Marcimedes/JBC_T245_Controller/Pinouts/jbc_iron_stand_pinout(BINDER_99-0624-00-07).JPG

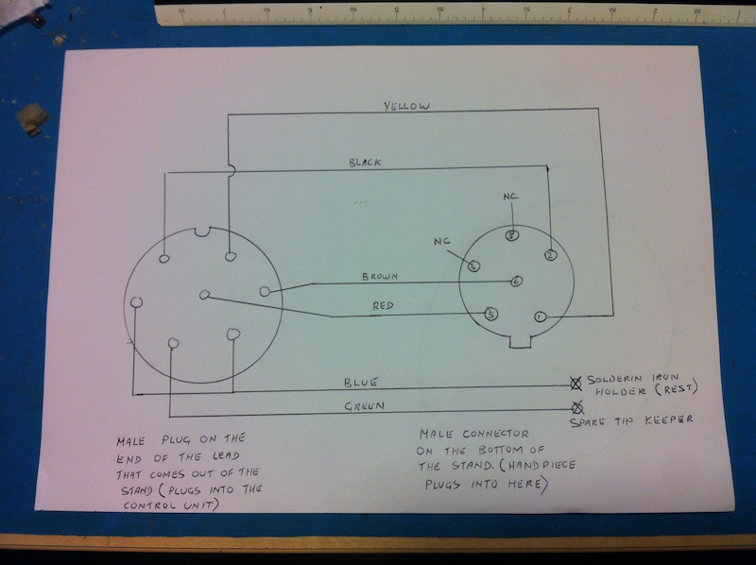
Pinouts/jbc_iron_stand_pinout(BINDER_99-0624-00-07).JPG
