Marcimedes/JBC_T245_Controller/README.md

# JBC_T245_Controller
JBC T245 Controller

Mounting Holes:
2.1 mm dia.
64mm x 74mm 

Board:
71mm x 80mm
