Marcimedes/JBC_T245_Controller/Design_Goals.txt

1. Safe: 
	- No mains voltage on board
	- ESD + surge protection
	- Thermocouple fault detection
	- Heater resistance monitoring
2. Simple
	- No specialty parts
	- Arduino compatible MCU
	- Hand solderable, no SMD
	- 5% temperature accuracy
3. Cheap
	- 2 layer board
	- Few ICs
	- 24V transformer, single secondary
