Marcimedes/JBC_T245_Controller/Schematic/Simple_T245_Controller.png

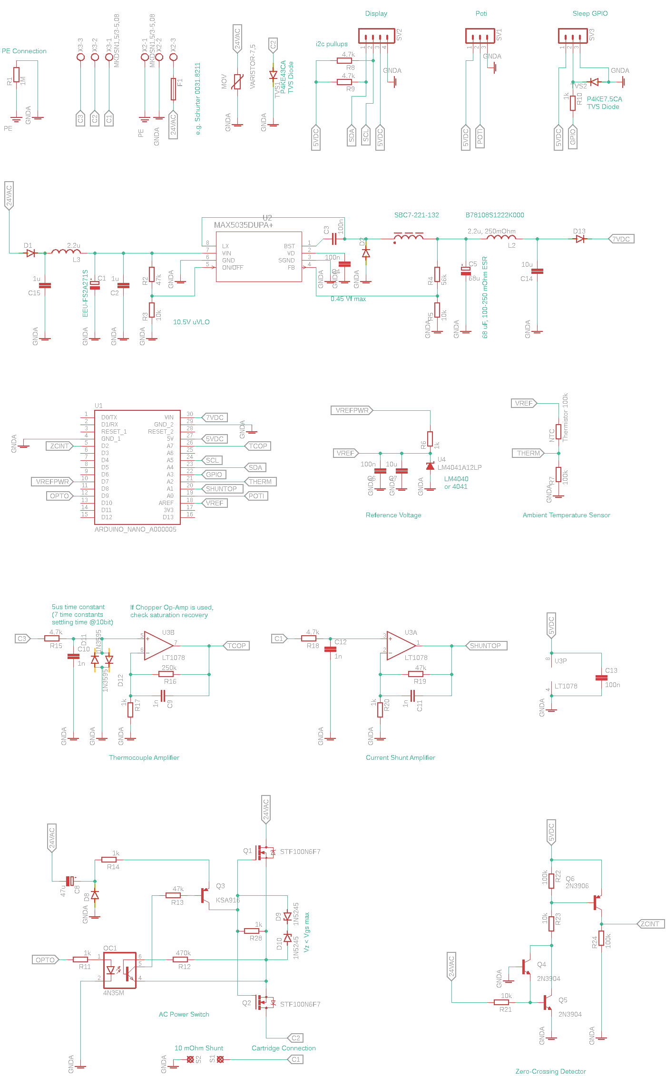
Schematic/Simple_T245_Controller.png
